szechy/usb-pd-investigation/eagle-cad/usb-pd.brd

## EAGLE design eagle-cad/usb-pd.brd (2017-01-02)

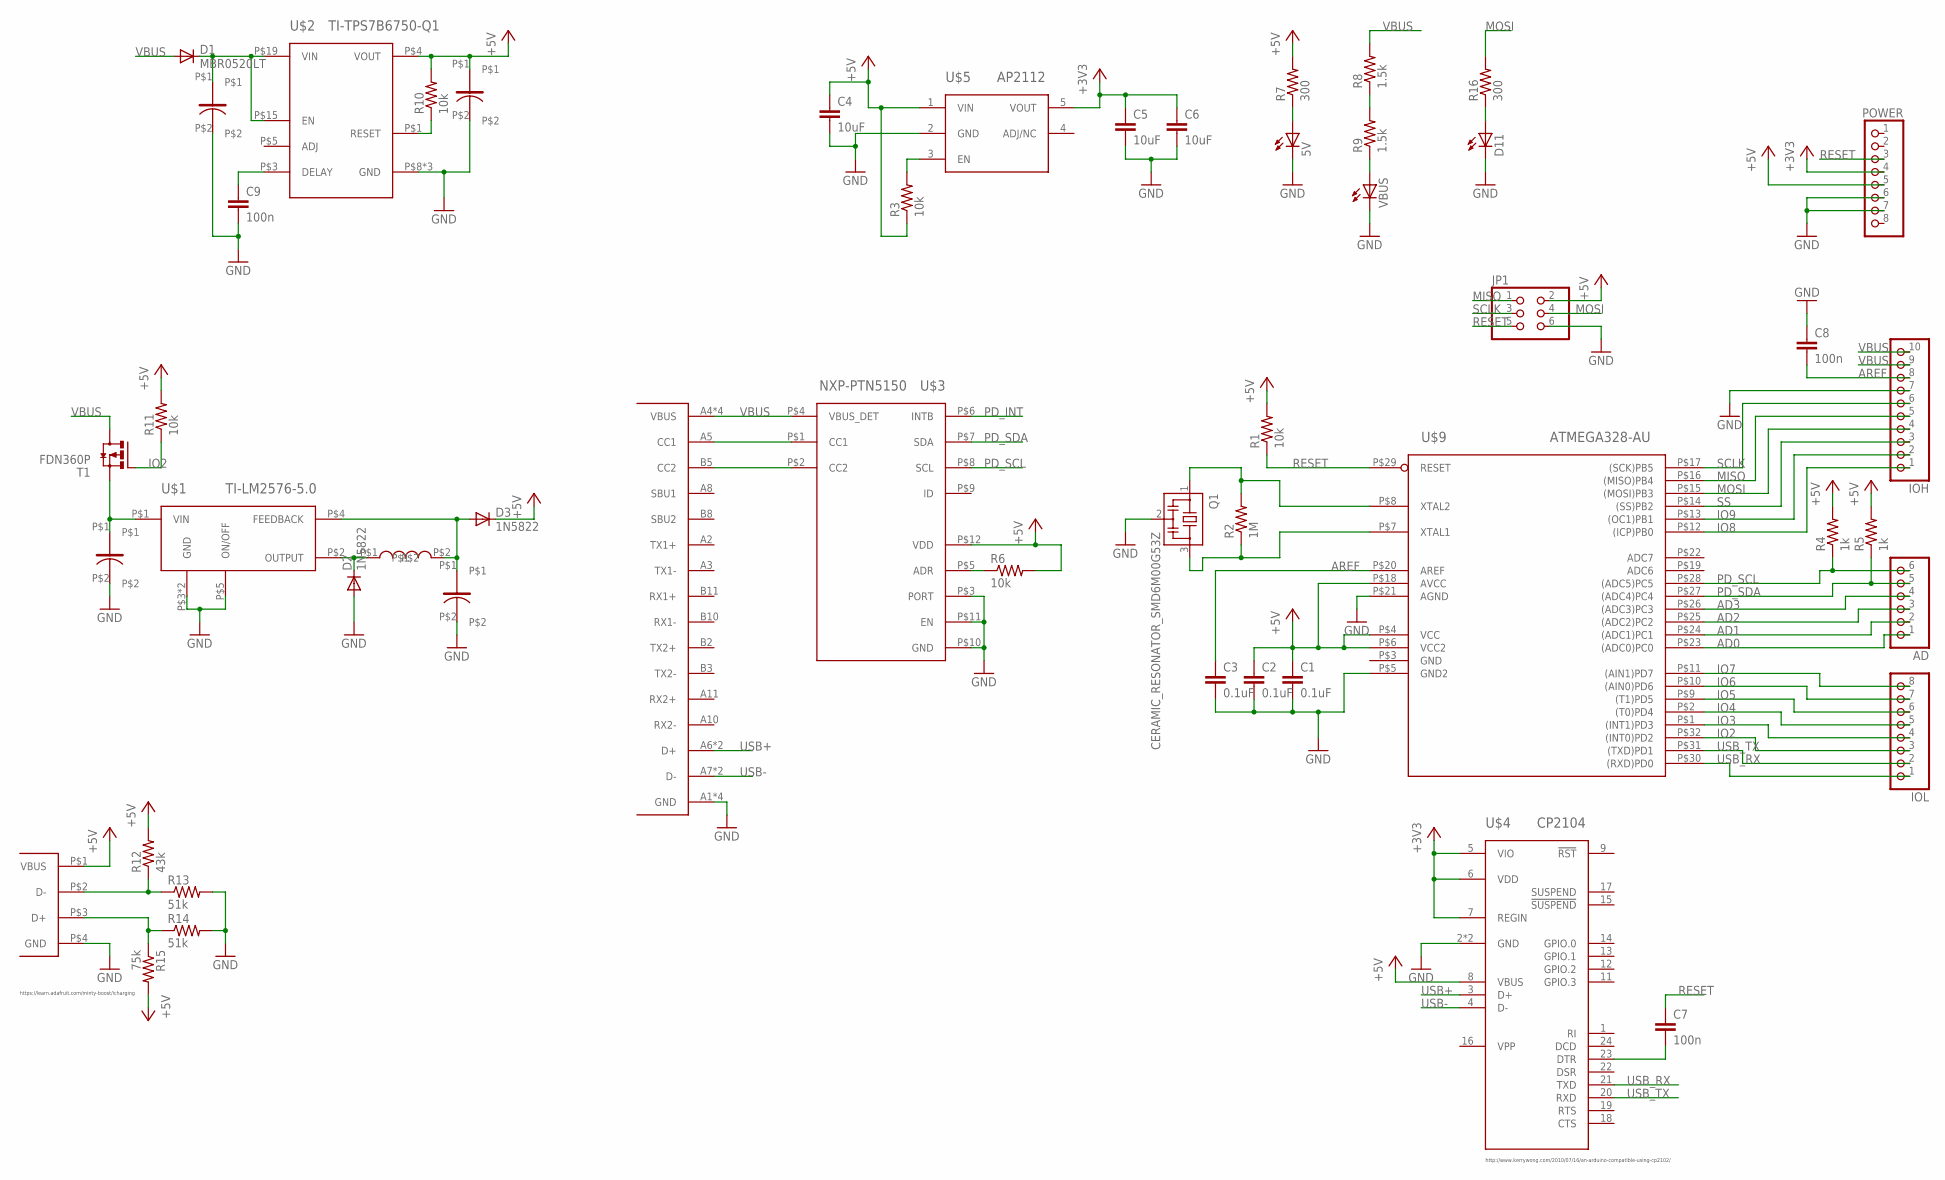
[picture p1: schematic usb-pd.sch]

Parts:
5V: LEDCHIPLED_0603; CHIPLED_0603
AD: PINHD-1X6; 1X06
C1, C2, C3: 0.1uF; C0402
C4, C5, C6: 10uF; C0805
C7, C8: 100n; C0402
C9: 100n; C0603
C10: UWT1V101MCL1GS
C11: AVE108M10G24T-F; AVE108M10G
C12: WURTH-865080543009-47uF; WURTH-865090543005
C13: WURTH-865090543005-22uF; WURTH-865090543005
D1: MBR0520LT; SOD123
D2, D3: 1N5822; DO201-15
D11: LEDCHIPLED_0603; CHIPLED_0603
IOH: PINHD-1X10; 1X10
IOL: PINHD-1X8; 1X08
J$1: TYPE-C-12401548E4; AMPHENOL-TYPE-C-12401548E4
J$2: UE27AC54100
JP1: PINHD-2X3; 2X03
POWER: PINHD-1X8; 1X08
Q1: CERAMIC_RESONATOR_SMD6M00G53Z; CERAMIC_RESONATOR_SMD
R1, R3, R6, R11: 10k; R0402
R2: 1M; R0402
R4, R5: 1k; R0402
R7, R16: 300; R0402
R8, R9: 1.5k; R0402
R10: 10k; R0805
R12: 43k; R0402
R13, R14: 51k; R0402
R15: 75k; R0402
T1: FDN360P; SUPER-SOT3
U$1: TI-LM2576-5.0; TO-263
U$2: TI-TPS7B6750-Q1; HTSSOP-20
U$3: NXP-PTN5150; X2QFN12
U$4: CP2104; QFN24_4X4
U$5: AP2112; SOT23-5L
U$7: WEURTH-784771101; 1260
U$9: ATMEGA328-AU; 32-TQFP
VBUS: LEDCHIPLED_0603; CHIPLED_0603

Connections:
+3V3: C5.1, C6.1, POWER.4, U$4.5 (VIO), U$4.6 (VDD), U$4.7 (REGIN), U$5.5 (VOUT)
+5V: C1.1, C2.1, C4.1, C13.P$1, D3.C, J$2.P$1 (VBUS), JP1.2, POWER.5, R1.2, R3.1, R4.2, R5.2, R6.2, R7.2, R10.2, R11.2, R12.2, R15.2, U$2.P$4 (VOUT), U$3.P$12 (VDD), U$4.8 (VBUS), U$5.1 (VIN), U$9.P$4 (VCC), U$9.P$6 (VCC2), U$9.P$18 (AVCC)
AD0: AD.1, U$9.P$23 ((ADC0)PC0)
AD1: AD.2, U$9.P$24 ((ADC1)PC1)
AD2: AD.3, U$9.P$25 ((ADC2)PC2)
AD3: AD.4, U$9.P$26 ((ADC3)PC3)
AREF: C3.1, C8.2, IOH.8, U$9.P$20 (AREF)
GND: 5V.C, C1.2, C2.2, C3.2, C4.2, C5.2, C6.2, C8.1, C9.2, C10.P$2, C11.P$2, C12.P$2, C13.P$2, D2.A, D11.C, IOH.7, J$1.A1 (GND), J$1.A12 (GND), J$1.B1 (GND), J$1.B12 (GND), J$2.P$4 (GND), JP1.6, POWER.6, POWER.7, Q1.2, R13.2, R14.2, U$1.P$3 (GND), U$1.P$5 (ON/OFF), U$1.P$6 (GND), U$2.P$8 (GND), U$2.P$13 (GND), U$2.P$21 (GND), U$3.P$3 (PORT), U$3.P$10 (GND), U$3.P$11 (EN), U$4.2 (GND), U$4.25 (GND), U$5.2 (GND), U$9.P$5 (GND2), U$9.P$21 (AGND), VBUS.C
IO2: IOL.3, R11.1, T1.1 (G), U$9.P$32 ((INT0)PD2)
IO3: IOL.4, U$9.P$1 ((INT1)PD3)
IO4: IOL.5, U$9.P$2 ((T0)PD4)
IO5: IOL.6, U$9.P$9 ((T1)PD5)
IO6: IOL.7, U$9.P$10 ((AIN0)PD6)
IO7: IOL.8, U$9.P$11 ((AIN1)PD7)
IO8: IOH.1, U$9.P$12 ((ICP)PB0)
IO9: IOH.2, U$9.P$13 ((OC1)PB1)
MISO: IOH.5, JP1.1, U$9.P$16 ((MISO)PB4)
MOSI: IOH.4, JP1.4, R16.2, U$9.P$15 ((MOSI)PB3)
unnamed: C10.P$1, T1.2 (S), U$1.P$1 (VIN)
unnamed: Q1.3, R2.1, U$9.P$7 (XTAL1)
unnamed: Q1.1, R2.2, U$9.P$8 (XTAL2)
unnamed: C7.2, U$4.23 (DTR)
unnamed: J$1.A5 (CC1), U$3.P$1 (CC1)
unnamed: J$1.B5 (CC2), U$3.P$2 (CC2)
unnamed: R3.2, U$5.3 (EN)
unnamed: R6.1, U$3.P$5 (ADR)
unnamed: D2.C, U$1.P$2 (OUTPUT), U$7.P$1
unnamed: 5V.A, R7.1
unnamed: R9.1, VBUS.A
unnamed: R8.1, R9.2
unnamed: R10.1, U$2.P$1 (RESET)
unnamed: C9.1, U$2.P$3 (DELAY)
unnamed: C11.P$1, D3.A, U$1.P$4 (FEEDBACK), U$7.P$2
unnamed: D11.A, R16.1
unnamed: J$2.P$2 (D-), R12.1, R13.1
unnamed: J$2.P$3 (D+), R14.1, R15.1
unnamed: C12.P$1, D1.C, U$2.P$15 (EN), U$2.P$19 (VIN)
PD_INT: U$3.P$6 (INTB)
PD_SCL: AD.6, R4.1, U$3.P$8 (SCL), U$9.P$28 ((ADC5)PC5)
PD_SDA: AD.5, R5.1, U$3.P$7 (SDA), U$9.P$27 ((ADC4)PC4)
RESET: C7.1, JP1.5, POWER.3, R1.1, U$9.P$29 (RESET)
SCLK: IOH.6, JP1.3, U$9.P$17 ((SCK)PB5)
SS: IOH.3, U$9.P$14 ((SS)PB2)
USB+: J$1.A6 (D+), J$1.B6 (D+), U$4.3 (D+)
USB-: J$1.A7 (D-), J$1.B7 (D-), U$4.4 (D-)
USB_RX: IOL.1, U$4.21 (TXD), U$9.P$30 ((RXD)PD0)
USB_TX: IOL.2, U$4.20 (RXD), U$9.P$31 ((TXD)PD1)
VBUS: D1.A, IOH.9, IOH.10, J$1.A4 (VBUS), J$1.A9 (VBUS), J$1.B4 (VBUS), J$1.B9 (VBUS), R8.2, T1.3 (D), U$3.P$4 (VBUS_DET)

Notes on the sheet:
http://www.kerrywong.com/2010/07/16/an-arduino-compatible-using-cp2102/
https://learn.adafruit.com/minty-boost/icharging

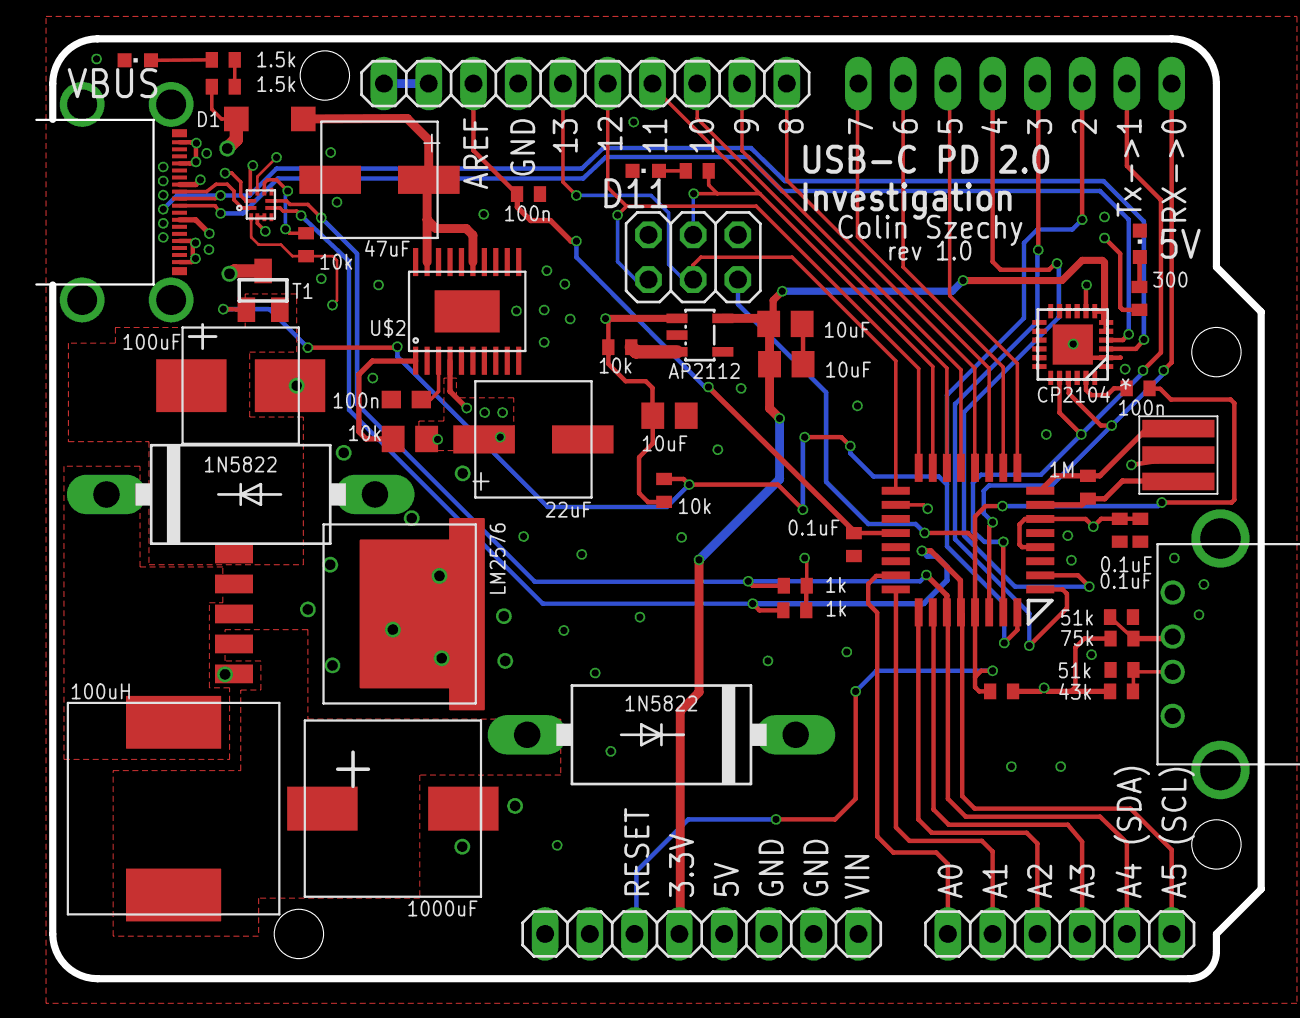
[picture p2: board usb-pd.brd from above]

Board: 4 copper layers, 69.5 x 53.3 mm, 51 parts (1 on the bottom side), 47 nets.
