szechy/usb-pd-investigation/(commit log)

2016-12-22 Started EAGLE schematic with copying ATMEga328 implementation from Arduino Uno, adding CP2104 implementation, 3v3 LDO implementation from MHacks Hacker Boards
    [usb-pd.brd, usb-pd.sch]
2016-12-22 Filled out PTN5150, arranged board like an Uno rev3
    [usb-pd.brd, usb-pd.sch]
2016-12-23 Added 5V buck implementation (need power FET to control it)
    [usb-pd.brd, usb-pd.sch]
2016-12-23 Added a n-channel power MOSFET to serve as controlling power FET for 5V buck. Definitely needs review
    [usb-pd.brd, usb-pd.sch]
2016-12-23 switched to p-channel because I'm dumb
    [usb-pd.brd, usb-pd.sch]
2016-12-23 Started researching proper capacitors, modified parts to have name and value on schematic
    [usb-pd.brd, usb-pd.sch]
2016-12-23 Finished placement, started routing
    [usb-pd.brd, usb-pd.sch]
2016-12-24 Entire-board-routed, rev-1. This is going to need a lot of revisions.
    [usb-pd.brd, usb-pd.sch]
2016-12-24 Added stitching vias and played with ground planes
    [usb-pd.brd]
2016-12-24 Pushed DRC down to only 17 errors (from 550)
    [usb-pd.brd]
2016-12-24 Fix disconnected ground plane
    [usb-pd.brd]
2016-12-25 Added new USB-C port, going to look at four-layer boards to get better Osh Park hole tolerances and ton of space for power planes
    [usb-pd.brd, usb-pd.sch]
2016-12-25 Minor changes
    [usb-pd.brd]
2016-12-30 Went to a 4-layer board design with a stackup of signal, GND, VCC, signal
    [usb-pd.brd, usb-pd.sch]
2016-12-30 Added new TypeC connector that has vias instead of slots - Osh Park can't do slots that small
    [usb-pd.brd, usb-pd.sch]
2017-01-02 Fixed notch by USB-C port as per OSH Park support ticket around slots
    [usb-pd.brd]
